09qwerty-org/Hellen-AE101-Corolla/pinout/ecu3.png

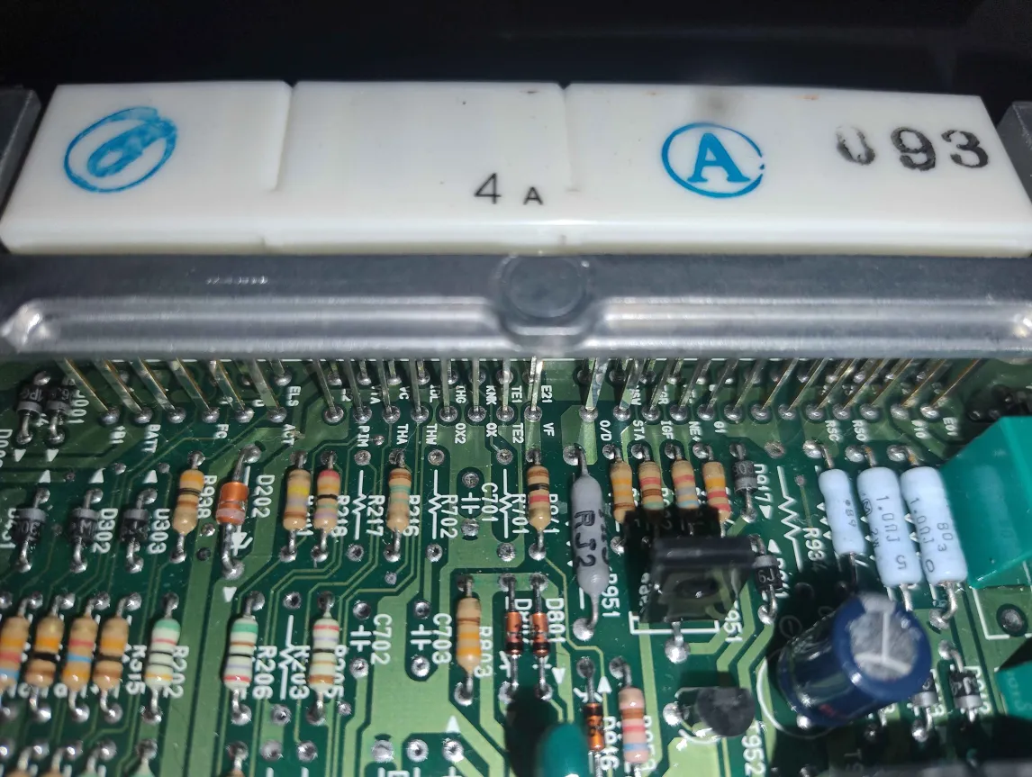
pinout/ecu3.png
