09qwerty-org/Hellen-AE101-Corolla/pinout/ecu1.png

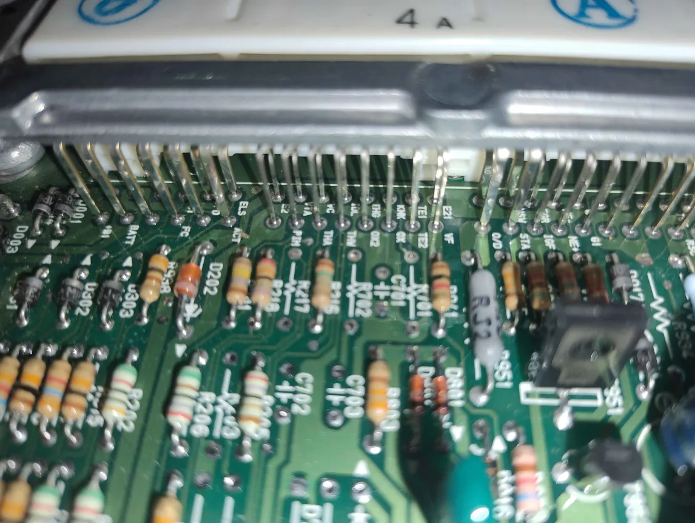
pinout/ecu1.png
