09qwerty-org/Hellen-AE101-Corolla/boards/AE101Corolla-a/board/AE101Corolla-a.png

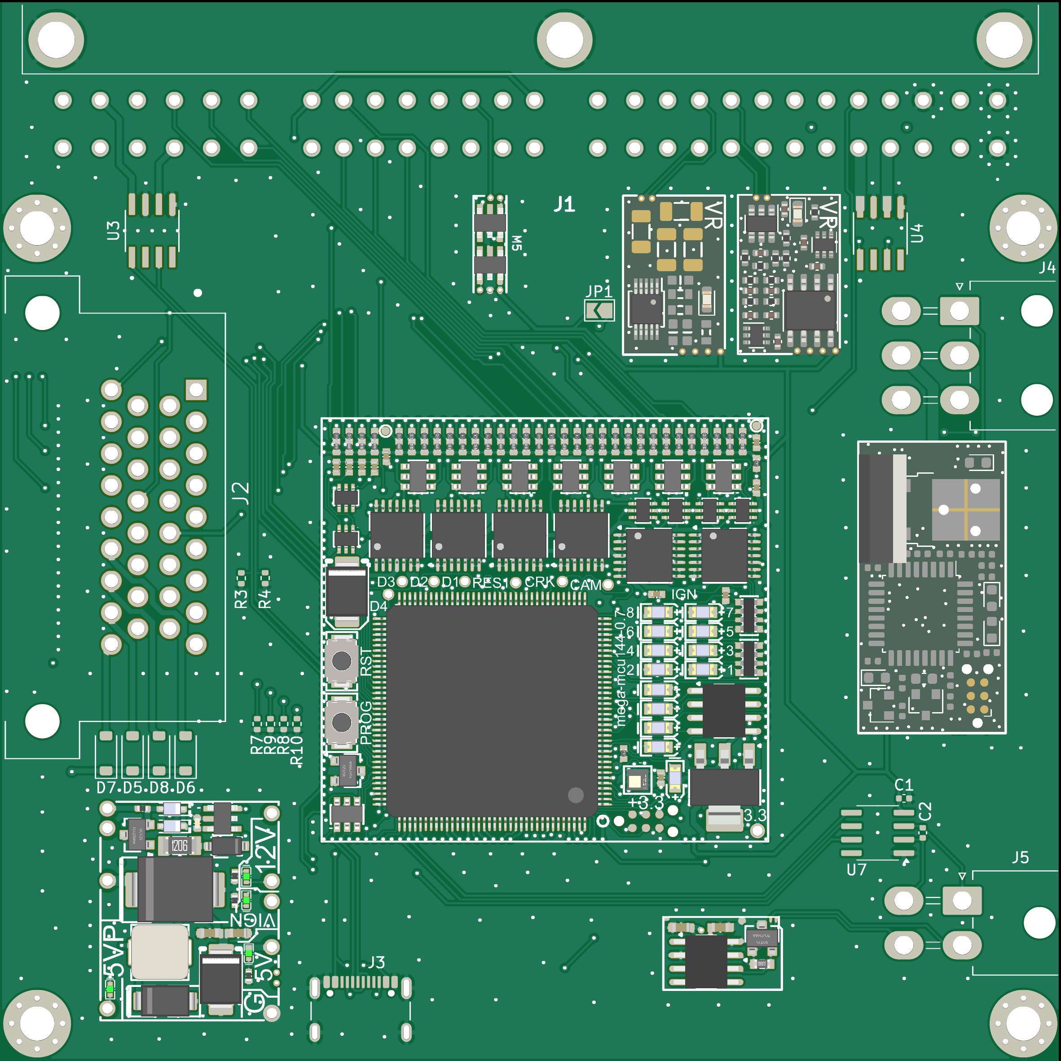
boards/AE101Corolla-a/board/AE101Corolla-a.png
