09qwerty-org/Hellen-AE101-Corolla/boards/AE101Corolla-a/board/misc/AE101Corolla-a-top.png

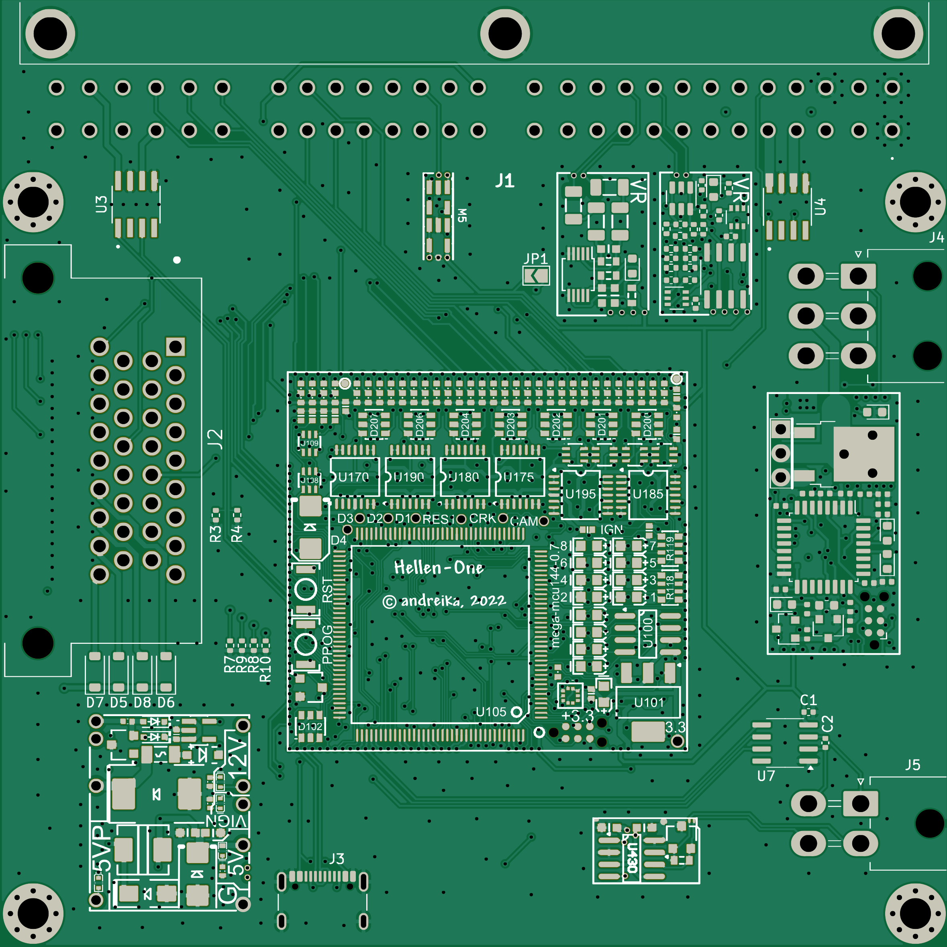
boards/AE101Corolla-a/board/misc/AE101Corolla-a-top.png
