09qwerty-org/Hellen-AE101-Corolla/pinout/ecu2.png

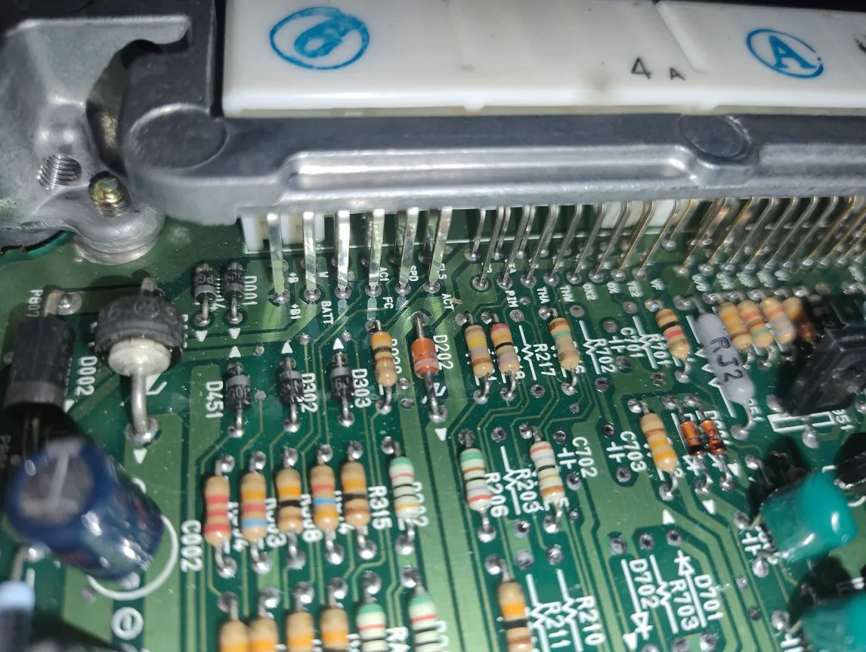
pinout/ecu2.png
