09qwerty-org/Hellen-AE101-Corolla/pinout/ecu4.png

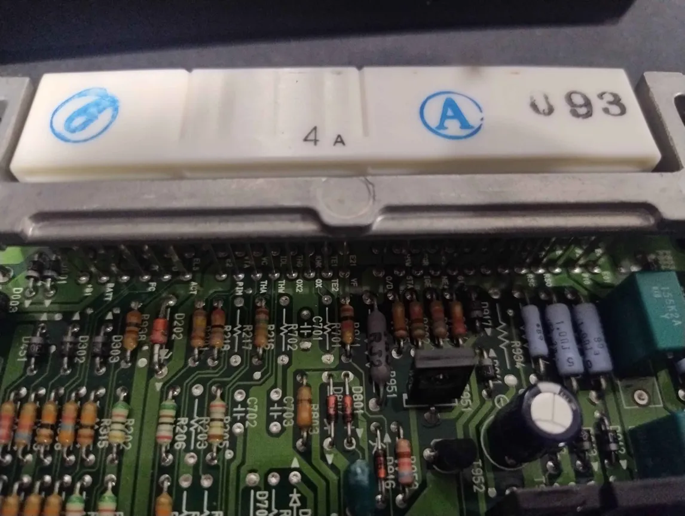
pinout/ecu4.png
