09qwerty-org/Hellen-AE101-Corolla/gerber/AE101Corolla.csv

Comment | Designator | Footprint | LCSC Part #
100n | C1 | Capacitor_SMD:C_0402_1005Metric | C1525
10n | C2 | Capacitor_SMD:C_0402_1005Metric | C15195
B5819W | D1 | Diode_SMD:D_SOD-123 | C8598
B5819W | D2 | Diode_SMD:D_SOD-123 | C8598
B5819W | D3 | Diode_SMD:D_SOD-123 | C8598
B5819W | D4 | Diode_SMD:D_SOD-123 | C8598
B5819W | D5 | Diode_SMD:D_SOD-123 | C8598
B5819W | D6 | Diode_SMD:D_SOD-123 | C8598
B5819W | D7 | Diode_SMD:D_SOD-123 | C8598
B5819W | D8 | Diode_SMD:D_SOD-123 | C8598
175448-6 | J1 | 175448-6:1754486
6437288-2 | J2 | superseal_34:TE_6437288-2
USB_C_Receptacle_USB2.0_14P | J3 | Connector_USB:USB_C_Receptacle_GCT_USB4105-xx-A_16P_TopMnt_Horizontal
Conn_02x03_Counter_Clockwise | J4 | Connector_Molex:Molex_Mini-Fit_Jr_5569-06A2_2x03_P4.20mm_Horizontal
Conn_02x02_Counter_Clockwise | J5 | Connector_Molex:Molex_Mini-Fit_Jr_5569-04A2_2x02_P4.20mm_Horizontal
Module-mega-mcu144-0.7 | M1 | megamcu144:mega-mcu144
Module-vr-discrete-0.5 | M2 | vr-discrete:vr-discrete
Module-vr-max9924-0.1 | M3 | vrmax9924:vr-max9924
Module-power_12and5V-0.3 | M4 | power5_12:power_12and5V
Module-knock-0.2 | M5 | knock:knock
Module-can-0.1 | M6 | can:can
Module-wbo-0.5 | M7 | wbo:wbo
4.7k | R1 | Resistor_SMD:R_0402_1005Metric | C25900
4.7k | R2 | Resistor_SMD:R_0402_1005Metric | C25900
4.7k | R3 | Resistor_SMD:R_0402_1005Metric | C25900
4.7k | R4 | Resistor_SMD:R_0402_1005Metric | C25900
5.1k | R5 | Resistor_SMD:R_0402_1005Metric | C144745
5.1k | R6 | Resistor_SMD:R_0402_1005Metric | C144745
4.7k | R7 | Resistor_SMD:R_0402_1005Metric | C25900
4.7k | R8 | Resistor_SMD:R_0402_1005Metric | C25900
4.7k | R9 | Resistor_SMD:R_0402_1005Metric | C25900
4.7k | R10 | Resistor_SMD:R_0402_1005Metric | C25900
4.7k | R11 | Resistor_SMD:R_0402_1005Metric | C25900
4.7k | R12 | Resistor_SMD:R_0402_1005Metric | C25900
4.7k | R13 | Resistor_SMD:R_0402_1005Metric | C25900
4.7k | R14 | Resistor_SMD:R_0402_1005Metric | C25900
~ | U1 | VNLD5090-E:VNLD5090-E | C222209
~ | U2 | VNLD5090-E:VNLD5090-E | C222209
~ | U3 | VNLD5090-E:VNLD5090-E | C222209
~ | U4 | VNLD5090-E:VNLD5090-E | C222209
~ | U5 | VNLD5090-E:VNLD5090-E | C222209
~ | U6 | VNLD5090-E:VNLD5090-E | C222209
MAX31855KASA | U7 | Package_SO:SOIC-8_3.9x4.9mm_P1.27mm
