09qwerty-org/Hellen-AE101-Corolla/AE101Corolla.kicad_pcb

## KiCad design AE101Corolla.kicad_pcb (2026-02-17)

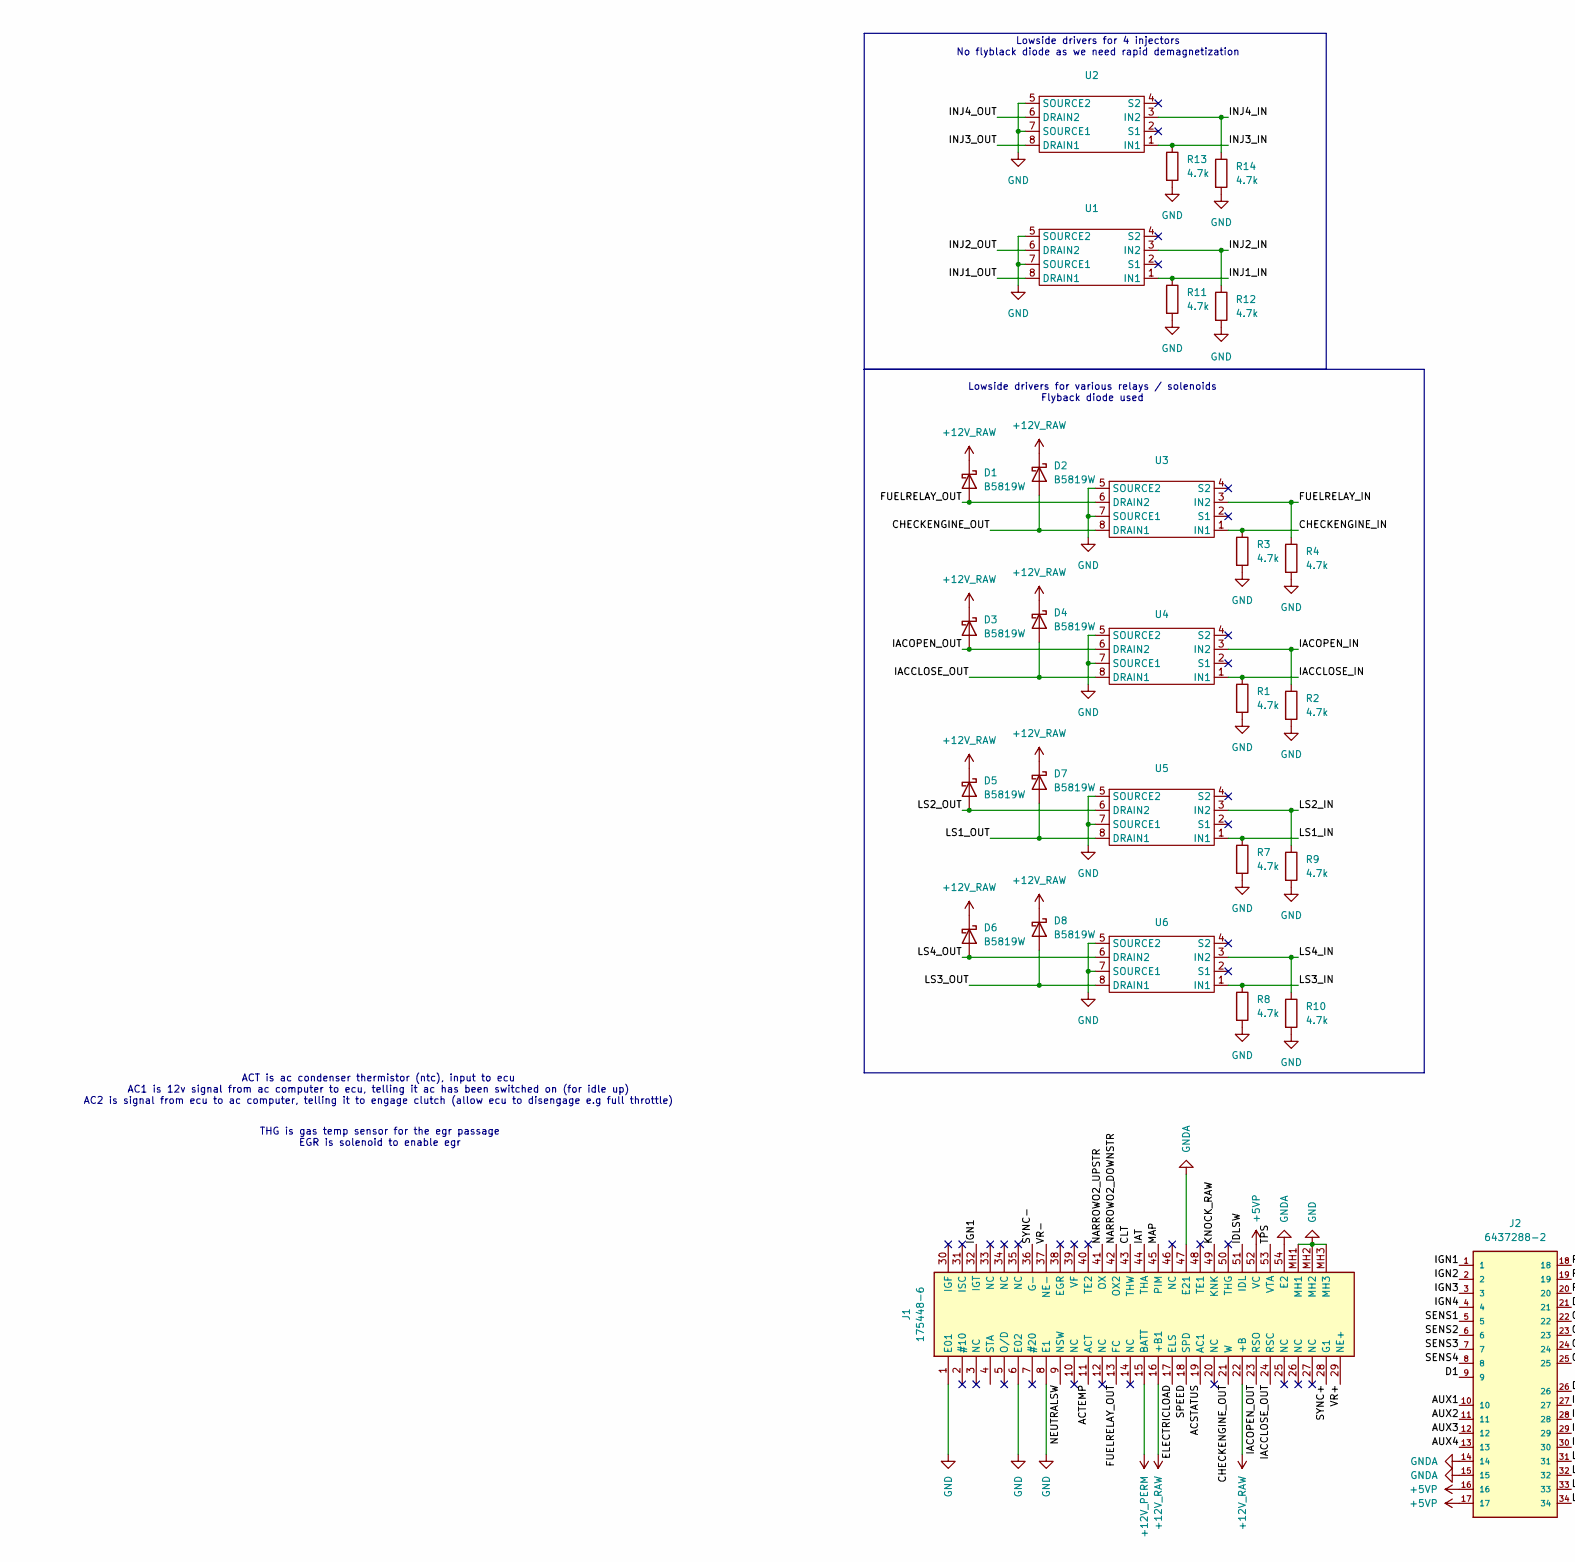
[picture p32: schematic AE101Corolla.kicad_sch, part in row 1, column 1]

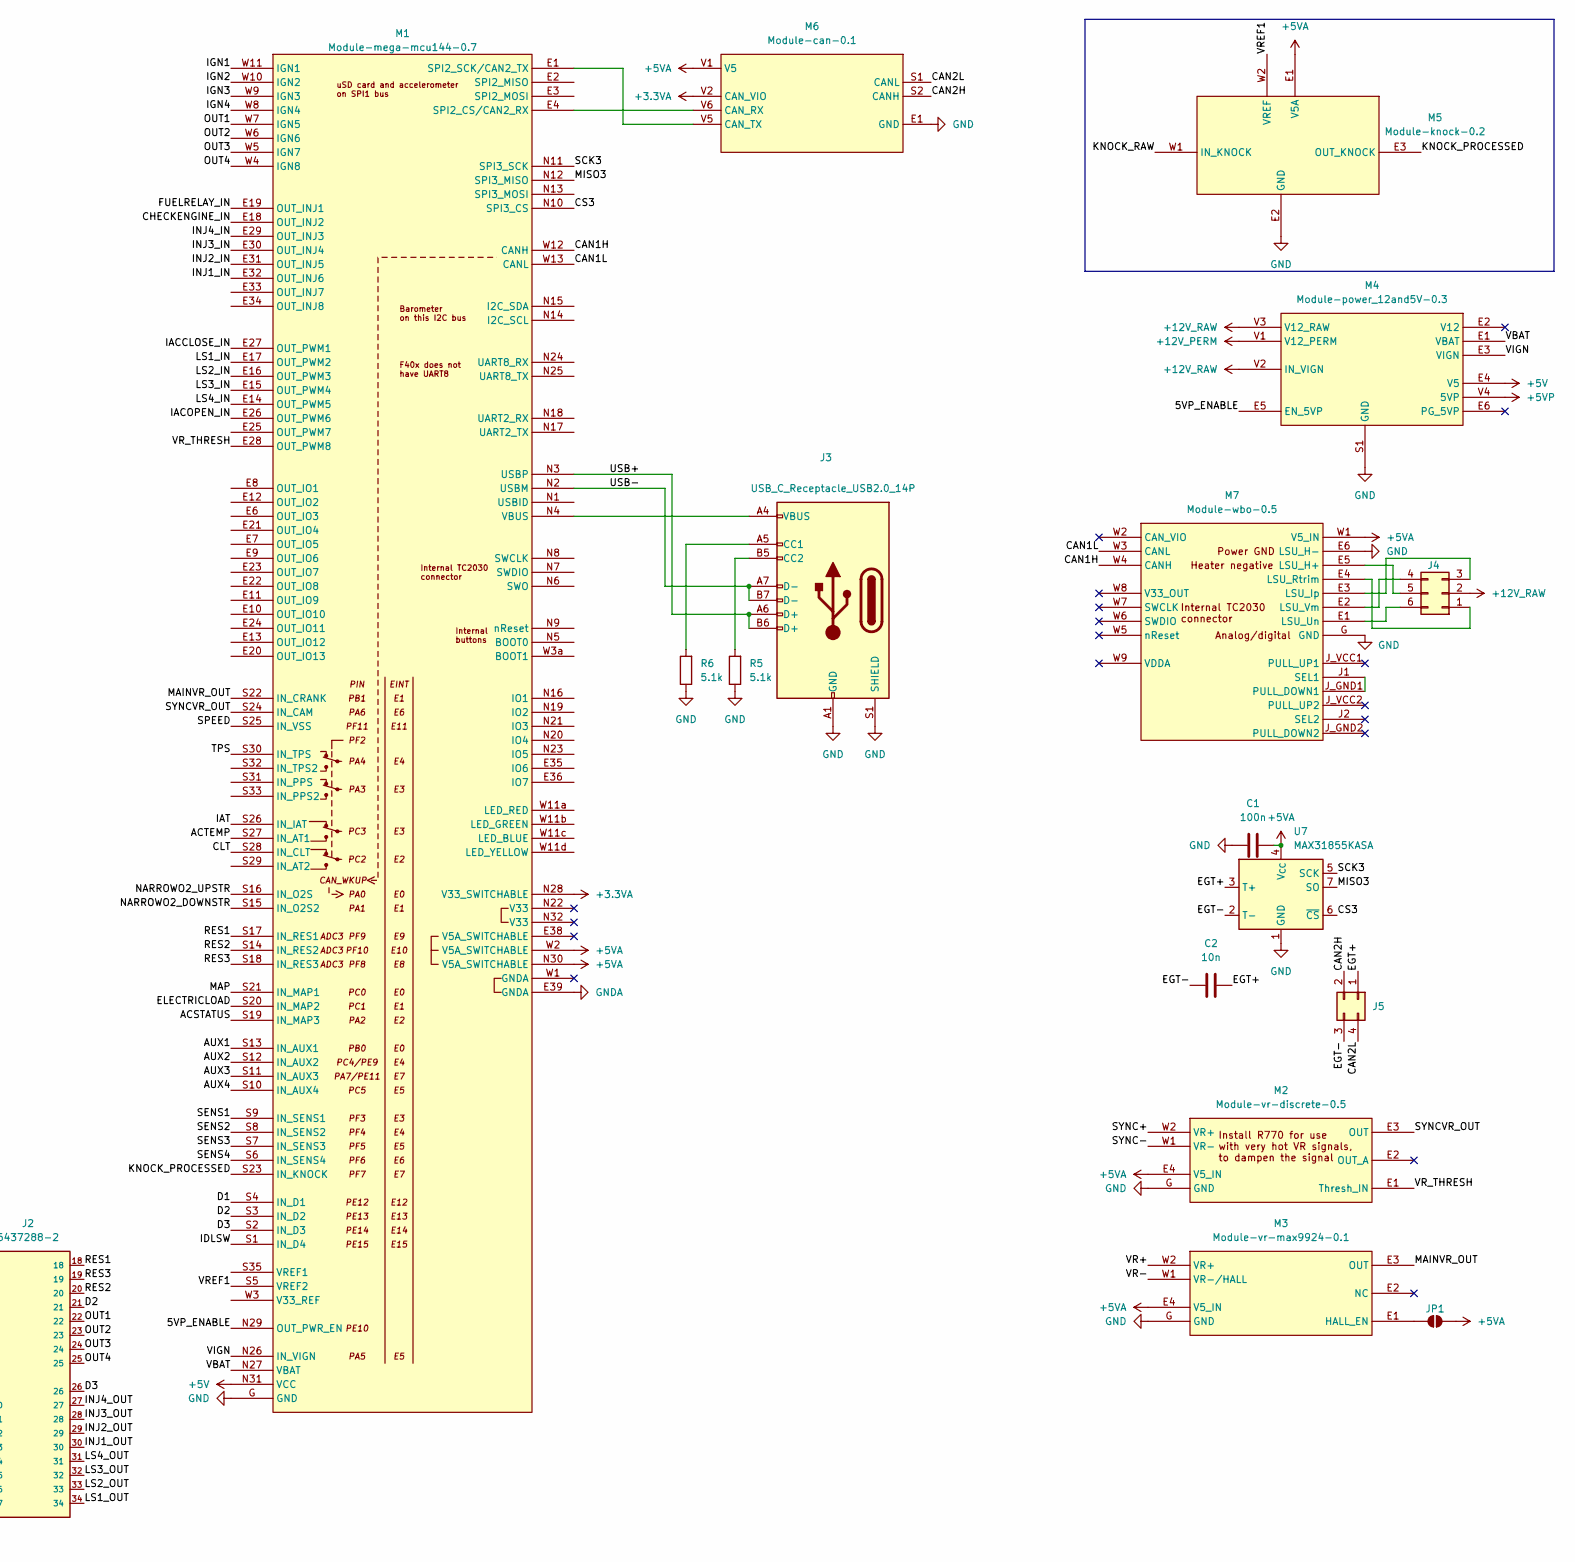
[picture p33: schematic AE101Corolla.kicad_sch, part in row 1, column 2]

Parts:
C1: 100n; C_0402_1005Metric; LCSC C1525
C2: 10n; C_0402_1005Metric; LCSC C15195
D1, D2, D3, D4, D5, D6, D7, D8: B5819W; D_SOD-123; LCSC C8598
J1: 175448-6; 1754486; Mouser Part Number 571-175448-6
J2: 6437288-2; TE_6437288-2; PARTREV A1
J3: USB_C_Receptacle_USB2.0_14P; USB_C_Receptacle_GCT_USB4105-xx-A_16P_TopMnt_Horizontal
J4: Conn_02x03_Counter_Clockwise; Molex_Mini-Fit_Jr_5569-06A2_2x03_P4.20mm_Horizontal
J5: Conn_02x02_Counter_Clockwise; Molex_Mini-Fit_Jr_5569-04A2_2x02_P4.20mm_Horizontal
JP1: SolderJumper_2_Open; SolderJumper-2_P1.3mm_Open_TrianglePad1.0x1.5mm
M1: Module-mega-mcu144-0.7; mega-mcu144
M2: Module-vr-discrete-0.5; vr-discrete
M3: Module-vr-max9924-0.1; vr-max9924
M4: Module-power_12and5V-0.3; power_12and5V
M5: Module-knock-0.2; knock
M6: Module-can-0.1; can
M7: Module-wbo-0.5; wbo
R1, R2, R3, R4, R7, R8, R9, R10, R11, R12, R13, R14: 4.7k; R_0402_1005Metric; LCSC C25900
R5, R6: 5.1k; R_0402_1005Metric; LCSC C144745
U1, U2, U3, U4, U5, U6: VNLD5090-E; LCSC C222209
U7: MAX31855KASA; SOIC-8_3.9x4.9mm_P1.27mm

Connections:
+3.3VA: M1.N28 (V33_SWITCHABLE), M6.V2 (CAN_VIO)
+5V: M1.N31 (VCC), M4.E4 (V5)
+5VA: C1.1, JP1.2 (B), M1.N30 (V5A_SWITCHABLE), M1.W2 (V5A_SWITCHABLE), M2.E4 (V5_IN), M3.E4 (V5_IN), M5.E1 (V5A), M6.V1 (V5), M7.W1 (V5_IN), U7.4 (V_{CC})
+5VP: J1.52 (VC), J2.16, J2.17, M4.V4 (5VP)
+12V_PERM: J1.15 (BATT), M4.V1 (V12_PERM)
+12V_RAW: D1.1 (K), D2.1 (K), D3.1 (K), D4.1 (K), D5.1 (K), D6.1 (K), D7.1 (K), D8.1 (K), J1.16 (+B1), J1.22 (+B), J4.2, M4.V2 (IN_VIGN), M4.V3 (V12_RAW)
/5VP_ENABLE: M1.N29 (OUT_PWR_EN), M4.E5 (EN_5VP)
/ACSTATUS: J1.19 (AC1), M1.S19 (IN_MAP3)
/ACTEMP: J1.11 (ACT), M1.S27 (IN_AT1)
/AUX1: J2.10, M1.S13 (IN_AUX1)
/AUX2: J2.11, M1.S12 (IN_AUX2)
/AUX3: J2.12, M1.S11 (IN_AUX3)
/AUX4: J2.13, M1.S10 (IN_AUX4)
/CAN1H: M1.W12 (CANH), M7.W4 (CANH)
/CAN1L: M1.W13 (CANL), M7.W3 (CANL)
/CAN2H: J5.2, M6.S2 (CANH)
/CAN2L: J5.4, M6.S1 (CANL)
/CHECKENGINE_IN: M1.E18 (OUT_INJ2), R3.1, U3.1 (IN1)
/CHECKENGINE_OUT: D2.2 (A), J1.21 (W), U3.8 (DRAIN1)
/CLT: J1.43 (THW), M1.S28 (IN_CLT)
/CS3: M1.N10 (SPI3_CS), U7.6 (~CS)
/D1: J2.9, M1.S4 (IN_D1)
/D2: J2.21, M1.S3 (IN_D2)
/D3: J2.26, M1.S2 (IN_D3)
/EGT+: C2.2, J5.1, U7.3 (T+)
/EGT-: C2.1, J5.3, U7.2 (T-)
/ELECTRICLOAD: J1.17 (ELS), M1.S20 (IN_MAP2)
/FUELRELAY_IN: M1.E19 (OUT_INJ1), R4.1, U3.3 (IN2)
/FUELRELAY_OUT: D1.2 (A), J1.13 (FC), U3.6 (DRAIN2)
/IACCLOSE_IN: M1.E27 (OUT_PWM1), R1.1, U4.1 (IN1)
/IACCLOSE_OUT: D4.2 (A), J1.24 (RSC), U4.8 (DRAIN1)
/IACOPEN_IN: M1.E26 (OUT_PWM6), R2.1, U4.3 (IN2)
/IACOPEN_OUT: D3.2 (A), J1.23 (RSO), U4.6 (DRAIN2)
/IAT: J1.44 (THA), M1.S26 (IN_IAT)
/IDLSW: J1.51 (IDL), M1.S1 (IN_D4)
/IGN1: J1.32 (IGT), J2.1, M1.W11 (IGN1)
/IGN2: J2.2, M1.W10 (IGN2)
/IGN3: J2.3, M1.W9 (IGN3)
/IGN4: J2.4, M1.W8 (IGN4)
/INJ1_IN: M1.E32 (OUT_INJ6), R11.1, U1.1 (IN1)
/INJ1_OUT: J2.30, U1.8 (DRAIN1)
/INJ2_IN: M1.E31 (OUT_INJ5), R12.1, U1.3 (IN2)
/INJ2_OUT: J2.29, U1.6 (DRAIN2)
/INJ3_IN: M1.E30 (OUT_INJ4), R13.1, U2.1 (IN1)
/INJ3_OUT: J2.28, U2.8 (DRAIN1)
/INJ4_IN: M1.E29 (OUT_INJ3), R14.1, U2.3 (IN2)
/INJ4_OUT: J2.27, U2.6 (DRAIN2)
/KNOCK_PROCESSED: M1.S23 (IN_KNOCK), M5.E3 (OUT_KNOCK)
/KNOCK_RAW: J1.49 (KNK), M5.W1 (IN_KNOCK)
/LS1_IN: M1.E17 (OUT_PWM2), R7.1, U5.1 (IN1)
/LS1_OUT: D7.2 (A), J2.34, U5.8 (DRAIN1)
/LS2_IN: M1.E16 (OUT_PWM3), R9.1, U5.3 (IN2)
/LS2_OUT: D5.2 (A), J2.33, U5.6 (DRAIN2)
/LS3_IN: M1.E15 (OUT_PWM4), R8.1, U6.1 (IN1)
/LS3_OUT: D8.2 (A), J2.32, U6.8 (DRAIN1)
/LS4_IN: M1.E14 (OUT_PWM5), R10.1, U6.3 (IN2)
/LS4_OUT: D6.2 (A), J2.31, U6.6 (DRAIN2)
/MAINVR_OUT: M1.S22 (IN_CRANK), M3.E3 (OUT)
/MAP: J1.45 (PIM), M1.S21 (IN_MAP1)
/MISO3: M1.N12 (SPI3_MISO), U7.7 (SO)
/NARROWO2_DOWNSTR: J1.42 (OX2), M1.S15 (IN_O2S2)
/NARROWO2_UPSTR: J1.41 (OX), M1.S16 (IN_O2S)
/NEUTRALSW: J1.9 (NSW)
/OUT1: J2.22, M1.W7 (IGN5)
/OUT2: J2.23, M1.W6 (IGN6)
/OUT3: J2.24, M1.W5 (IGN7)
/OUT4: J2.25, M1.W4 (IGN8)
/RES1: J2.18, M1.S17 (IN_RES1)
/RES2: J2.20, M1.S14 (IN_RES2)
/RES3: J2.19, M1.S18 (IN_RES3)
/SCK3: M1.N11 (SPI3_SCK), U7.5 (SCK)
/SENS1: J2.5, M1.S9 (IN_SENS1)
/SENS2: J2.6, M1.S8 (IN_SENS2)
/SENS3: J2.7, M1.S7 (IN_SENS3)
/SENS4: J2.8, M1.S6 (IN_SENS4)
/SPEED: J1.18 (SPD), M1.S25 (IN_VSS)
/SYNC+: J1.28 (G1), M2.W2 (VR+)
/SYNC-: J1.36 (G-), M2.W1 (VR-)
/SYNCVR_OUT: M1.S24 (IN_CAM), M2.E3 (OUT)
/TPS: J1.53 (VTA), M1.S30 (IN_TPS)
/USB+: J3.A6 (D+), J3.B6 (D+), M1.N3 (USBP)
/USB-: J3.A7 (D-), J3.B7 (D-), M1.N2 (USBM)
/VBAT: M1.N27 (VBAT), M4.E1 (VBAT)
/VIGN: M1.N26 (IN_VIGN), M4.E3 (VIGN)
/VR+: J1.29 (NE+), M3.W2 (VR+)
/VR-: J1.37 (NE-), M3.W1 (VR-/HALL)
/VREF1: M1.S5 (VREF2), M5.W2 (VREF)
/VR_THRESH: M1.E28 (OUT_PWM8), M2.E1 (Thresh_IN)
GND: C1.2, J1.1 (E01), J1.6 (E02), J1.8 (E1), J1.MH1, J1.MH2, J1.MH3, J3.A1 (GND), J3.A12 (GND), J3.B1 (GND), J3.B12 (GND), J3.S1 (SHIELD), M1.G (GND), M2.G (GND), M3.G (GND), M4.S1 (GND), M5.E2 (GND), M6.E1 (GND), M7.E6 (LSU_H-), M7.G (GND), R1.2, R2.2, R3.2, R4.2, R5.1, R6.1, R7.2, R8.2, R9.2, R10.2, R11.2, R12.2, R13.2, R14.2, U1.5 (SOURCE2), U1.7 (SOURCE1), U2.5 (SOURCE2), U2.7 (SOURCE1), U3.5 (SOURCE2), U3.7 (SOURCE1), U4.5 (SOURCE2), U4.7 (SOURCE1), U5.5 (SOURCE2), U5.7 (SOURCE1), U6.5 (SOURCE2), U6.7 (SOURCE1), U7.1 (GND)
GNDA: J1.47 (E21), J1.54 (E2), J2.14, J2.15, M1.E39 (GNDA)
unnamed: J3.A5 (CC1), R6.2
unnamed: J3.B5 (CC2), R5.2
unnamed: J4.1, M7.E4 (LSU_Rtrim)
unnamed: J4.3, M7.E3 (LSU_Ip)
unnamed: J4.4, M7.E2 (LSU_Vm)
unnamed: J4.5, M7.E5 (LSU_H+)
unnamed: J4.6, M7.E1 (LSU_Un)
unnamed: JP1.1 (A), M3.E1 (HALL_EN)
unnamed: M1.E4 (SPI2_CS/CAN2_RX), M6.V6 (CAN_RX)
unnamed: M1.E1 (SPI2_SCK/CAN2_TX), M6.V5 (CAN_TX)
unnamed: J3.A4 (VBUS), J3.A9 (VBUS), J3.B4 (VBUS), J3.B9 (VBUS), M1.N4 (VBUS)
unnamed: M7.J1 (SEL1), M7.J_GND1 (PULL_DOWN1)

Notes on the sheet:
ACT is ac condenser thermistor (ntc), input to ecu AC1 is 12v signal from ac computer to ecu, telling it ac has been switched on (for idle up) AC2 is signal from ecu to ac computer, telling it to engage clutch (allow ecu to disengage e.g full throttle)
Lowside drivers for various relays / solenoids Flyback diode used
Lowside drivers for 4 injectors No flyblack diode as we need rapid demagnetization
THG is gas temp sensor for the egr passage EGR is solenoid to enable egr

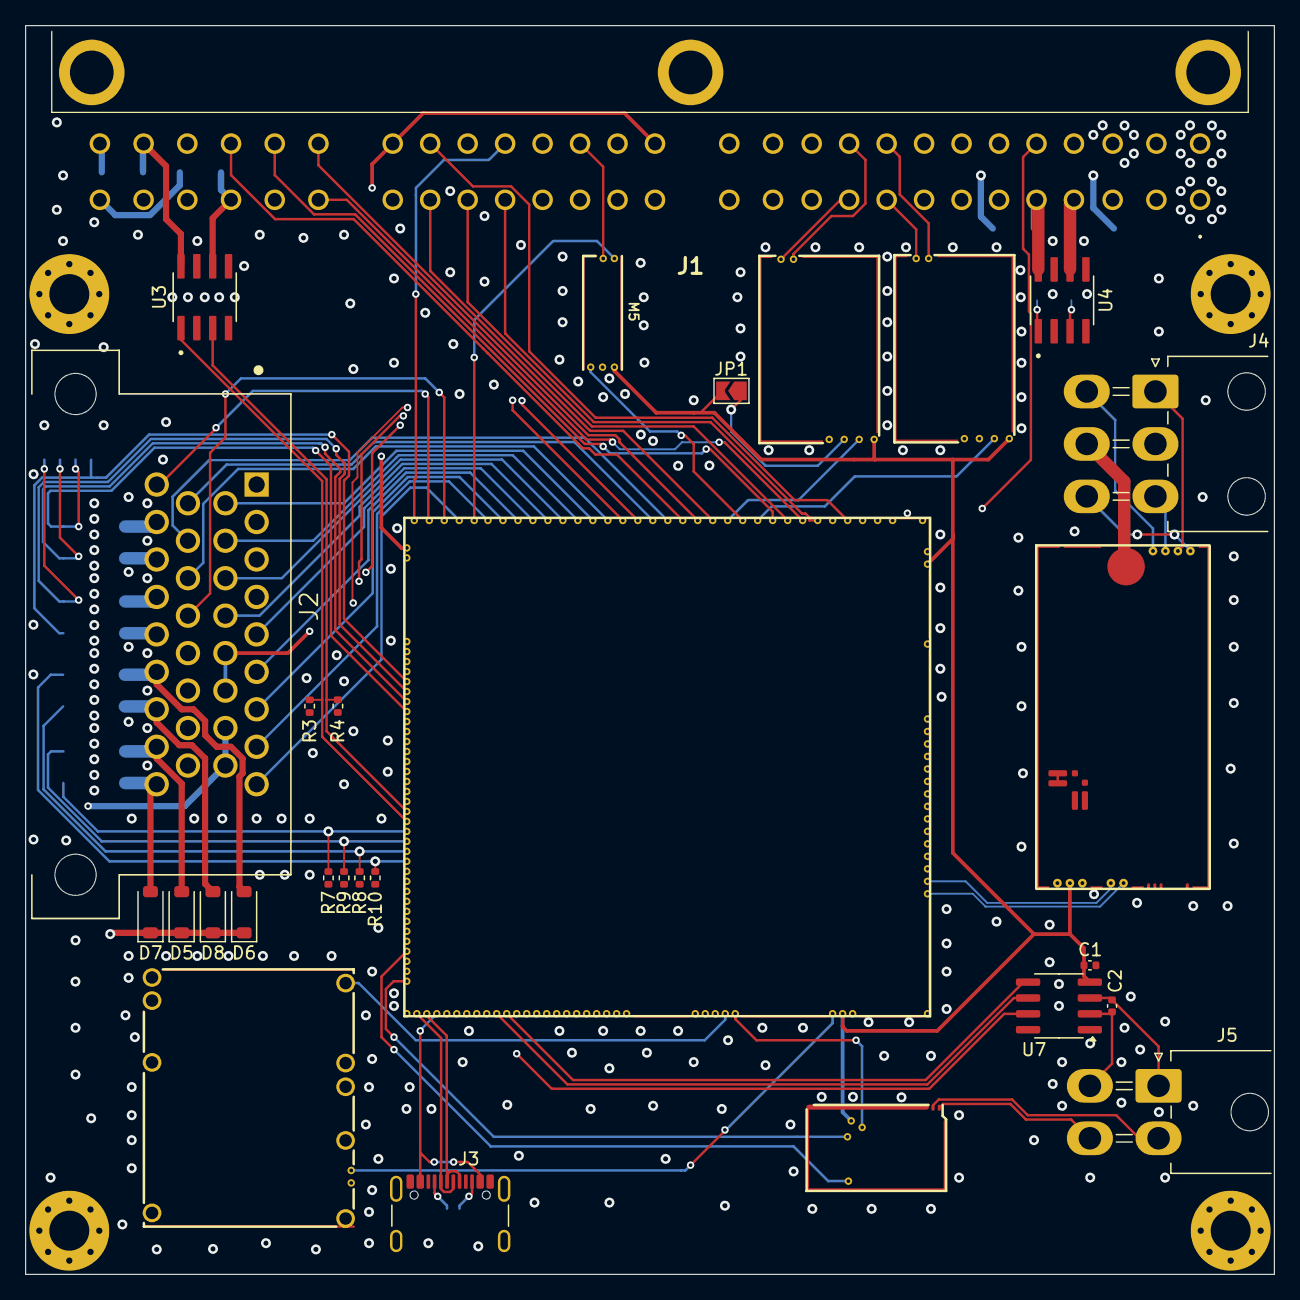
[picture p34: board AE101Corolla.kicad_pcb from above]

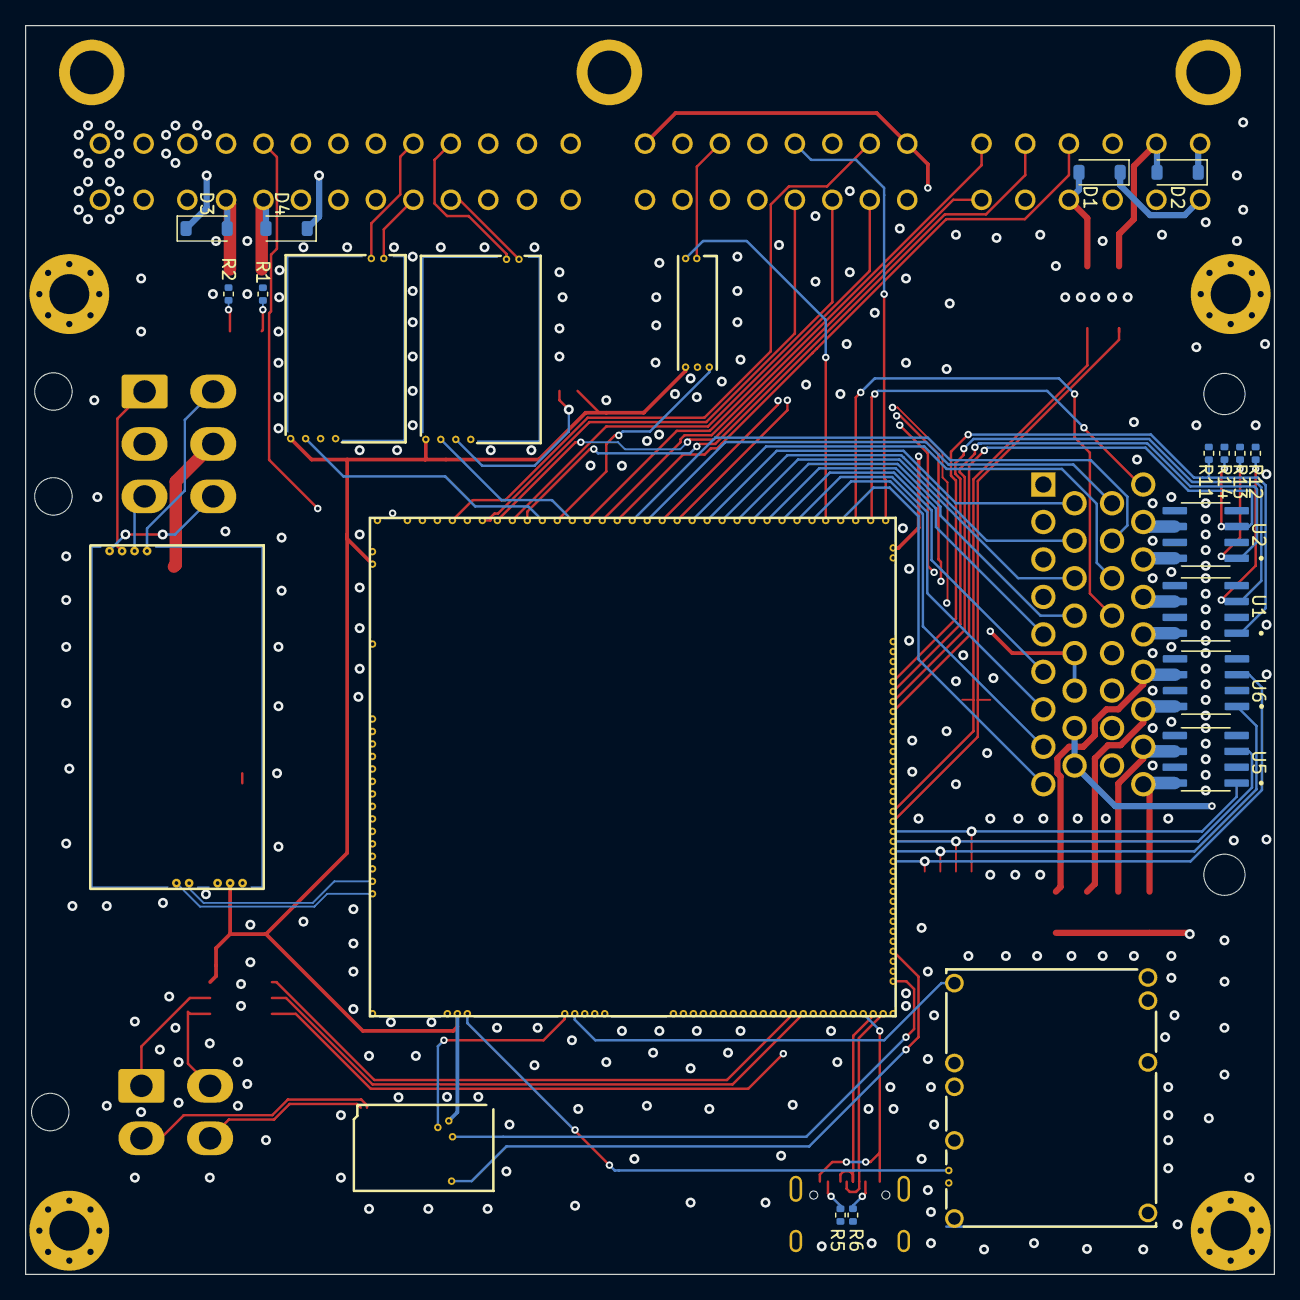
[picture p35: board AE101Corolla.kicad_pcb from below]

Board: 4 copper layers, 100.0 x 100.0 mm, 44 parts (16 on the bottom side), 101 nets.
