09qwerty-org/Hellen-AE101-Corolla/(commit log)

2026-01-30 GHA says update kicad6-libraries
2026-02-13 [skip actions] Auto-generated board v2.1
    [AE101Corolla-B_Cu.gbl, AE101Corolla-B_Mask.gbs, AE101Corolla-B_Paste.gbp, AE101Corolla-B_Silkscreen.gbo, AE101Corolla-Edge_Cuts.gm1, AE101Corolla-F_Cu.gtl, AE101Corolla-F_Mask.gts, AE101Corolla-F_Paste.gtp]
